nopisland/Sumositoire/Sumositoire_projet_etudiant/Sumositoire/jalon1/Planning_SUMOSITOIRE_B1a_eq2.pdf

# PLANNING DE DEVELOPPEMENT DU PROJET (PDP)

# Mise en place du planning de developpement

Action | NOM Prénom | Fonction | Date | Signature
Document complété par | MAFILAZA Donnie BOISSONNEAU Jimmy | Techniciens | 29/09/15
Planning validée par | BOISSONNEAU Jimmy | Chef de projet | 29/09/15

# IUT de Bordeaux

Département GEII | 1 / 2

# Etape du projet :

# Référence : RBS_PDP Révision : 1.0 – 01/09/2015

## PLANNING DE DEVELOPPEMENT DU PROJET (PDP)

TEMPS (en séance)

| | | | | S1 | | S2 | | | S3 | | S4 | | | S5 | | S6 | | | S7 | | S8 | | | S9 | | S10 | | | S11 | | S12 | | | S13 | | S14 | | | S15 | | S16 | | | S17 | | S18 | | | S19 | | S20 | | | S21
TACHE | TEMPS (en h) | EQUIPIERS | DUREE | 1 | 2 | 3 | 4 | 5 | 6 | 7 | 8 | 9 | 10 | 11 | 12 | 13 | 14 | 15 | 16 | 17 | 18 | 19 | 20 | 21 | 22 | 23 | 24 | 25 | 26 | 27 | 28 | 29 | 30 | 31 | 32 | 33 | 34 | 35 | 36 | 37 | 38 | 39 | 40 | 41 | 42 | 43 | 44 | 45 | 46 | 47 | 48 | 49 | 50 | 51 | 52 | COMMENTAIRES
1 | REVUE DE LANCEMENT DE DEVELOPPEMENT | Présentation du projet
2 | FORMATION PROCESSUS | Présentation du processus de développement
3 | CAHIER DES CHARGES | Prise de connaissance des exigences
4 | PLANNING | Prise de connaissance du planning prévisionnel du projet
5 | RESSOURCES HUMAINES | Constitution des groupes et des binômes 12, 34, 56 et 78
6 | COUT | Prise de connaissance du coût prévisionnel du projet
7 | ARCHITECTURE MECANIQUE | Analyse de la conformité des solutions techniques disponibles par rapport aux exigences
8 | ARCHITECTURE ELECTRONIQUE | Association exigences et blocs architecturaux du projet
9 | ARCHITECTURE ELECTRONIQUE EXEMPLE | Analyse de l'exemple fourni
10 | ARCHITECTURE ELECTRONIQUE ACQUISITION | Recherche solutions techniques en réponse aux exigences (avec analyse des composants d'acquisitions disponibles)
11 | ARCHITECTURE ELECTRONIQUE TRAITEMENT | Recherche solutions techniques en réponse aux exigences (avec des fonctionnalités du composant de traitement disponible)
12 | ARCHITECTURE ELECTRONIQUE ACTION | Recherche solutions techniques en réponse aux exigences (avec analyse du composant d'action disponible (caractéristiques mécanique, tension, courant + protocole de commande))
13 | ARCHITECTURE ELECTRONIQUE ENERGIE | Analyse de la conformité des solutions techniques disponibles par rapport aux exigences
14 | ARCHITECTURE INFORMATIQUE | Association exigences et blocs architecturaux du projet
15 | ARCHITECTURE INFORMATIQUE EXEMPLE | Analyse de l'exemple fourni
16 | ARCHITECTURE INFORMATIQUE ACQUISITION | Déclarations des prototypes des fonctions d'acquisition
17 | ARCHITECTURE INFORMATIQUE TRAITEMENT | Déclarations des prototypes des fonctions de traitement
18 | ARCHITECTURE INFORMATIQUE ACTION | Déclarations des prototypes des fonctions d'action
19 | ARCHITECTURE MECANIQUE
20 | ARCHITECTURE ELECTRONIQUE
21 | ARCHITECTURE INFORMATIQUE
22 | REVUE DE CONCEPTION PRELIMINAIRE | Préparation checklist + revue
23 | CONCEPTION ELECTRONIQUE ACQUISITION | Lecture datasheet, calcul, simulation
24 | CONCEPTION ELECTRONIQUE TRAITEMENT | Lecture datasheet
25 | CONCEPTION ELECTRONIQUE ACTION | Lecture datasheet, calcul, simulation
26 | CONCEPTION ELECTRONIQUE ENERGIE | Lecture datasheet, calcul, simulation
27 | CONCEPTION ELECTRONIQUE CIRCUIT IMPRIME | schéma électrique, placement, routage
28 | CONCEPTION INFORMATIQUE ACQUISITION | Définitions et instanciations des prototypes des fonctions d'acquisition
29 | CONCEPTION INFORMATIQUE TRAITEMENT | Définitions et instanciations des fonctions de traitement
30 | CONCEPTION INFORMATIQUE ACTION | Définitions et instanciations des fonctions d'action
31 | CONCEPTION MECANIQUE | Construction de plan mécanique
32 | CONCEPTION ELECTRONIQUE DDC
33 | CONCEPTION INFORMATIQUE DDC
34 | CONCEPTION ELECTRONIQUE DDF | Rédaction du DDF + traçabilité entre paragraphes de fabrication et exigences clients
35 | CONCEPTION MECANIQUE DDF | Rédaction du DDF + traçabilité entre paragraphes de fabrication et exigences clients
36 | REVUE DE CONCEPTION DETAILLEE | Préparation checklist + revue
37 | FABRICATION MECANIQUE | Réalisation de la structure mécanique
38 | FABRICATION ELECTRONIQUE | Réalisation du circuit électronique
39 | REVUE DE FABRICATION | Préparation checklist + revue
40 | TELECHARGEMENT INFORMATIQUE | Téléchargement du programme informatique dans le prototype
41 | DEBOGAGE ELECTRONIQUE | Mise-au-point du circuit électronique
42 | DEBOGAGE INFORMATIQUE | Mise-au-point du programme informatique
43 | ASSEMBLAGE | Mise-au-point mécanique, électronique et informatique après assemblage
44 | DEBOGAGE | Mise-au-point du prototype entièrement assemblé
45 | VERIFICATION MECANIQUE | Essais de vérification sur prototype + rédaction de l'essai dans le DDV
46 | VERIFICATION ACQUISITION | Essais de vérification sur prototype + rédaction de l'essai dans le DDV
47 | VERIFICATION TRAITEMENT | Essais de vérification sur prototype + rédaction de l'essai dans le DDV
48 | VERIFICATION ACTION | Essais de vérification sur prototype + rédaction de l'essai dans le DDV
49 | VERIFICATION ENERGIE | Essais de vérification sur prototype + rédaction de l'essai dans le DDV
50 | VERIFICATION DDV | Finalisation du DDV + traçabilité entre essais et exigences clients
51 | MARGE | Marge dans le planning
52 | DEMONSTRATION | Démonstration du bon fonctionnement du prototype développé
53 | REVUE DE FIN DE DEVELOPPEMENT | Préparation checklist + revue

GLOSSAIRE

Equipier1 | Equipier4 | Equipier7 | BOISSONNneau | MARANDEL
| | | BOUYER | SENEL
Equipier2 | Equipier5 | | LIZOT
| | | MAFILAZA
Equipier3 | Equipier6 | Equipiers1&2&3&4&5&6&7
1&3 | 4&6 | 2&5 | 1&5

Rédaction du chapitre « Conception Préliminaire » du DDC Rédaction du chapitre « Conception Préliminaire » du DDC Rédaction du chapitre « Conception Préliminaire » du DDC

Rédaction du chapitre « Conception détaillée » du DDC+ traçabilité entre paragraphes de conception et exigences clients Rédaction du chapitre « Conception détaillée » du DDC + traçabilité entre paragraphes de conception et exigences clients

Equipier 1 : | Equipier 5 :
Equipier 2 : | Equipier 6 :
Equipier 3 : | Equipier 7 :
Equipier 4 :
