nopisland/Sumositoire/Sumositoire_reborn/MECA/.m3d BambuLab P1S/batch complet.3mf

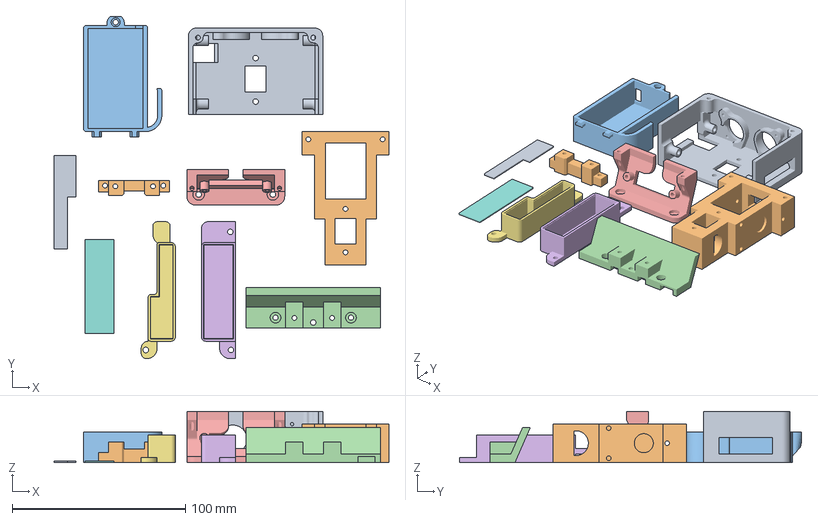
[picture p20: CAD file, 2026-01-16]
Sumositoire_reborn/MECA/.m3d BambuLab P1S/batch complet.3mf
193.2 x 197.4 x 29.5 mm
support ultrasons v55.stl
base v5.stl
batch_one_sumo - Part 1 v7.stl
parebot v6.stl
support sharp arrière v18.stl
ajout de poid en dessous droite v13.stl
ajout de poid en dessous Gauche v20.stl
couvverture poids droite v2.stl
couverture poids gauche v4.stl
capteur_arriere_dessous v4.stl
