nopisland/Sumositoire/Sumositoire_reborn/MECA/Fichier STL/ajout de poid en dessous droite v13.stl

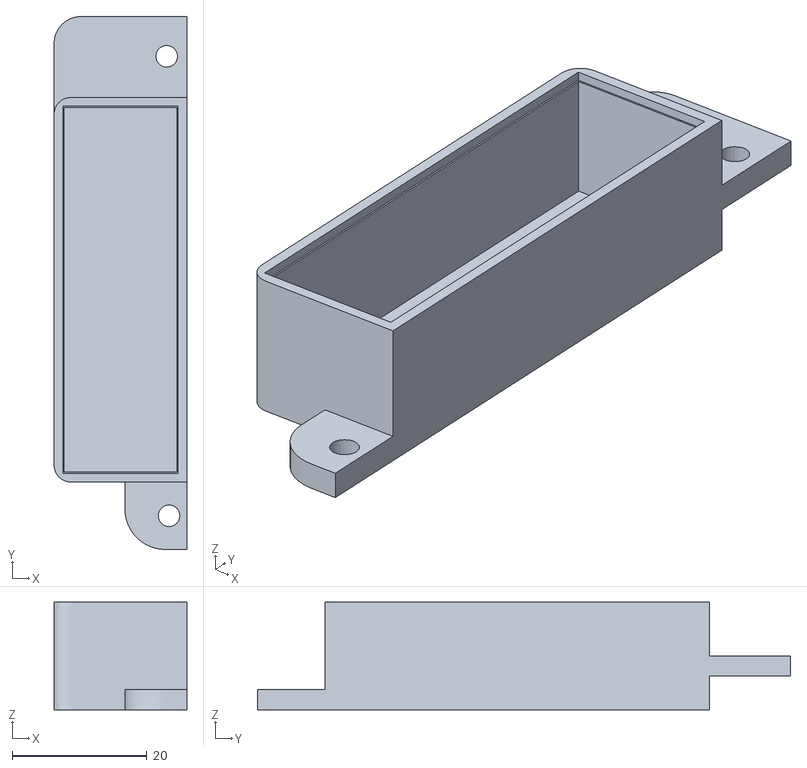
[picture p21: CAD file, 2026-01-16]
Sumositoire_reborn/MECA/Fichier STL/ajout de poid en dessous droite v13.stl
19.7 x 79.0 x 16.0
