nopisland/Sumositoire/Sumositoire_reborn/MECA/Modéle 3d Capteur et carte/cny_arriere.stl

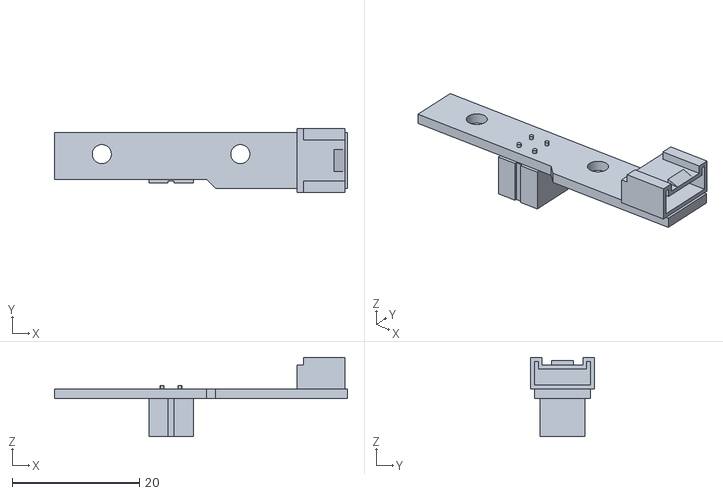
[picture p22: CAD file, 2026-01-16]
Sumositoire_reborn/MECA/Modéle 3d Capteur et carte/cny_arriere.stl
46.0 x 10.0 x 12.4
