nopisland/Sumositoire/Sumositoire_reborn/MECA/Fichier STL/support poids roues v15.stl

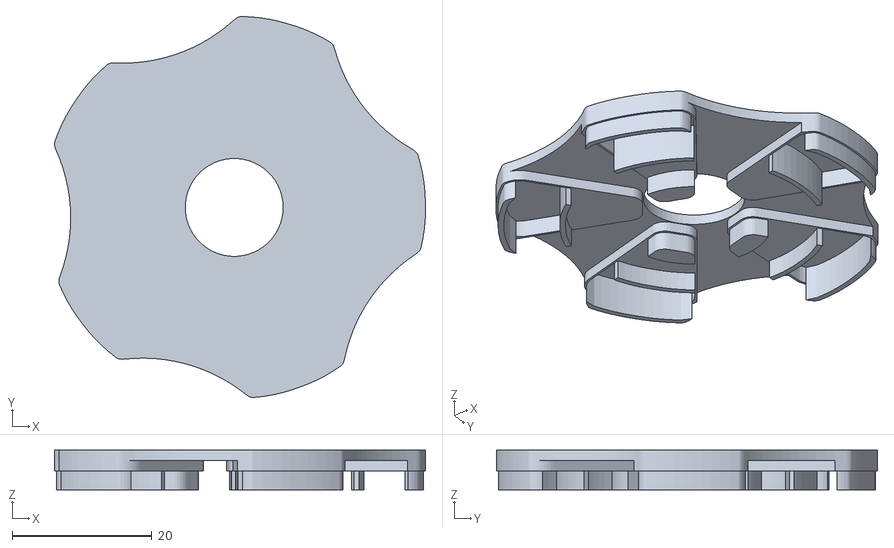
[picture p23: CAD file, 2026-01-16]
Sumositoire_reborn/MECA/Fichier STL/support poids roues v15.stl
53.1 x 54.5 x 5.70
