nopisland/Sumositoire/Sumositoire_reborn/MECA/Modéle 3d Capteur et carte/sharp.stl

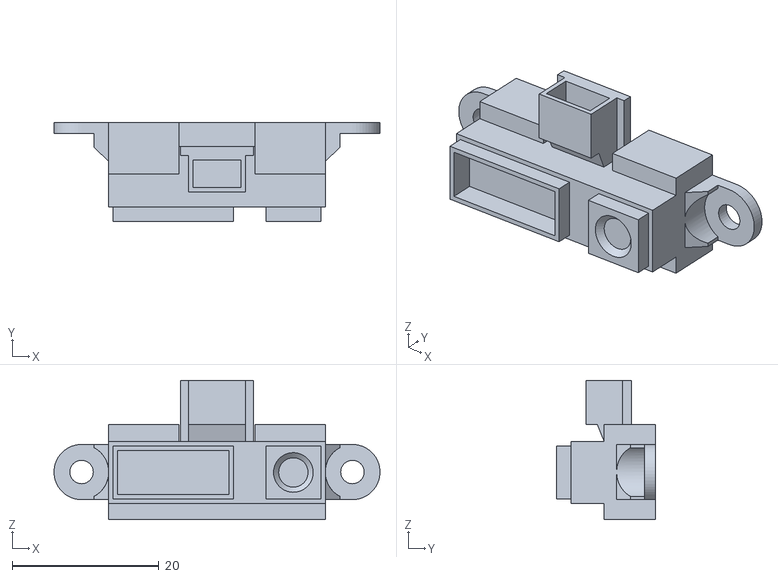
[picture p24: CAD file, 2026-01-16]
Sumositoire_reborn/MECA/Modéle 3d Capteur et carte/sharp.stl
44.4 x 13.5 x 19.0
