nopisland/Sumositoire/Sumositoire_reborn/MECA/Fichier STL/batch_one_sumo - Part 1 v7.stl

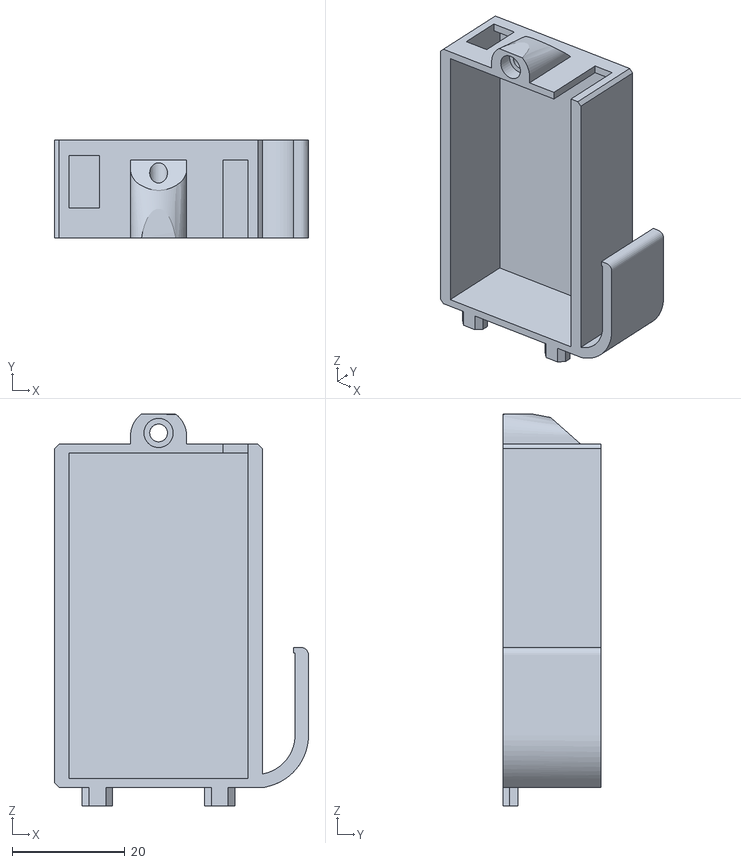
[picture p25: CAD file, 2026-01-16]
Sumositoire_reborn/MECA/Fichier STL/batch_one_sumo - Part 1 v7.stl
45.1 x 17.5 x 69.7
