nopisland/Sumositoire/Sumositoire_reborn/MECA/Modéle 3d Capteur et carte/roue.stl

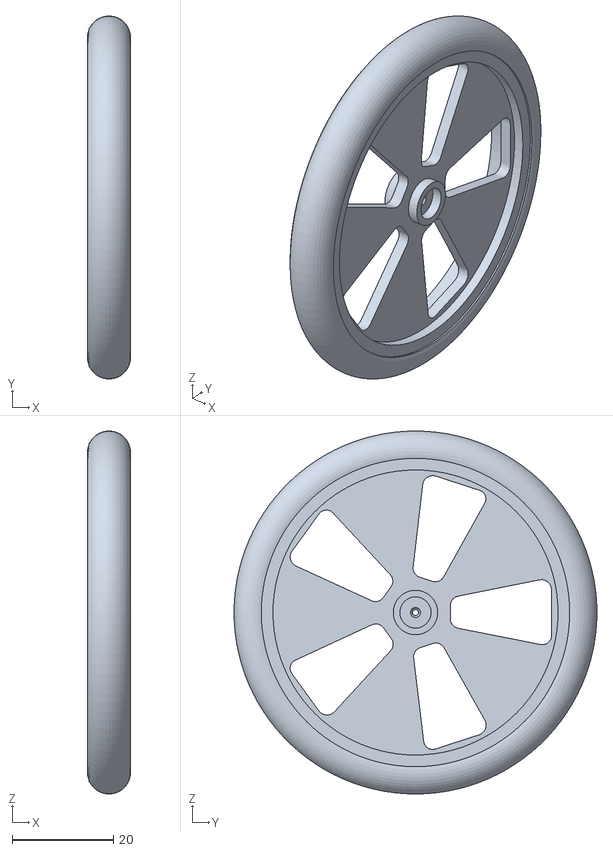
[picture p26: CAD file, 2026-01-16]
Sumositoire_reborn/MECA/Modéle 3d Capteur et carte/roue.stl
8.53 x 71.8 x 71.8
