nopisland/Sumositoire/Sumositoire_reborn/MECA/Fichier STL/base v5.stl

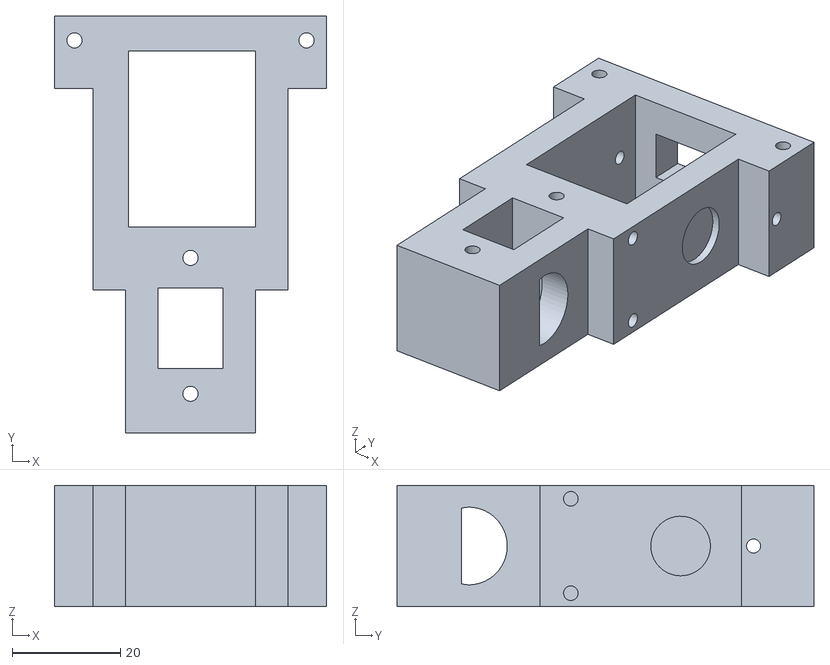
[picture p27: CAD file, 2026-01-16]
Sumositoire_reborn/MECA/Fichier STL/base v5.stl
50.2 x 76.9 x 22.3
