nopisland/Sumositoire/Sumositoire_reborn/MECA/Modéle 3d Capteur et carte/ultrason.stl

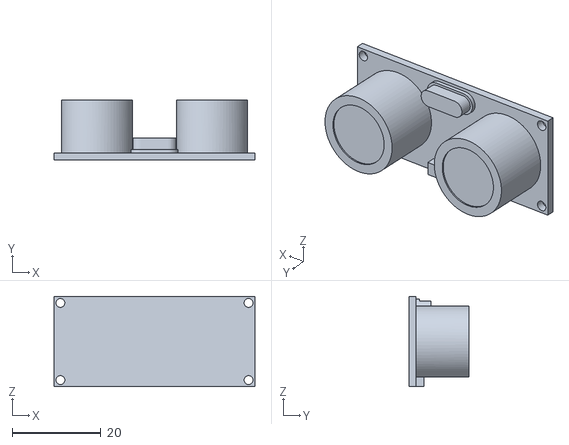
[picture p28: CAD file, 2026-01-16]
Sumositoire_reborn/MECA/Modéle 3d Capteur et carte/ultrason.stl
45.4 x 13.6 x 20.4
