nopisland/Sumositoire/Sumositoire_reborn/MECA/Fichier STL/capteur_arriere_dessous v4.stl

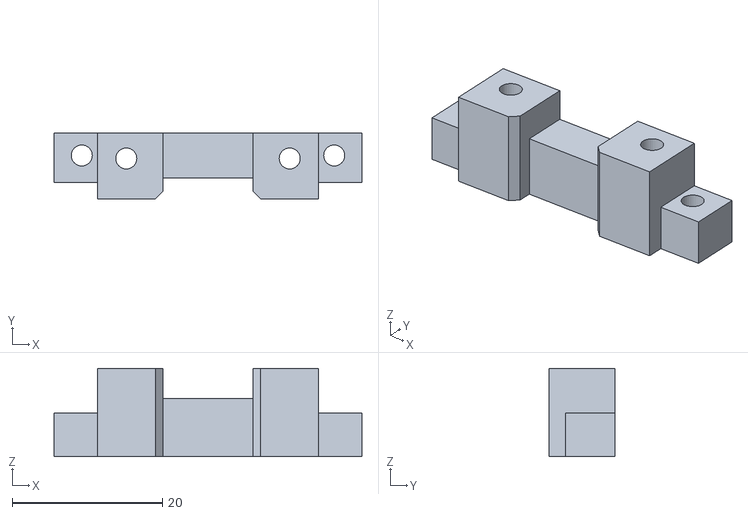
[picture p29: CAD file, 2026-01-16]
Sumositoire_reborn/MECA/Fichier STL/capteur_arriere_dessous v4.stl
41.0 x 8.80 x 11.7
