nopisland/Sumositoire/Sumositoire_reborn/MECA/Modéle 3d Capteur et carte/cny_avant.stl

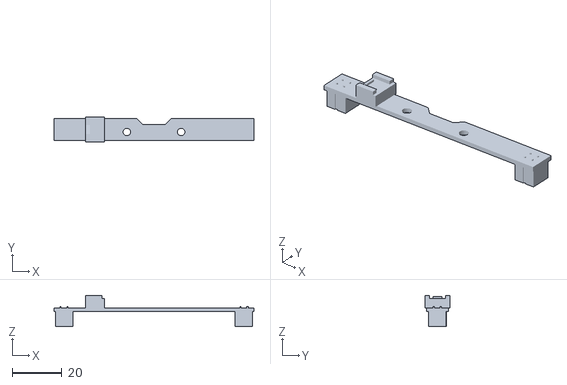
[picture p30: CAD file, 2026-01-16]
Sumositoire_reborn/MECA/Modéle 3d Capteur et carte/cny_avant.stl
80.0 x 10.0 x 12.4
