nopisland/Sumositoire/Sumositoire_reborn/MECA/Fichier STL/couvverture poids droite v2.stl

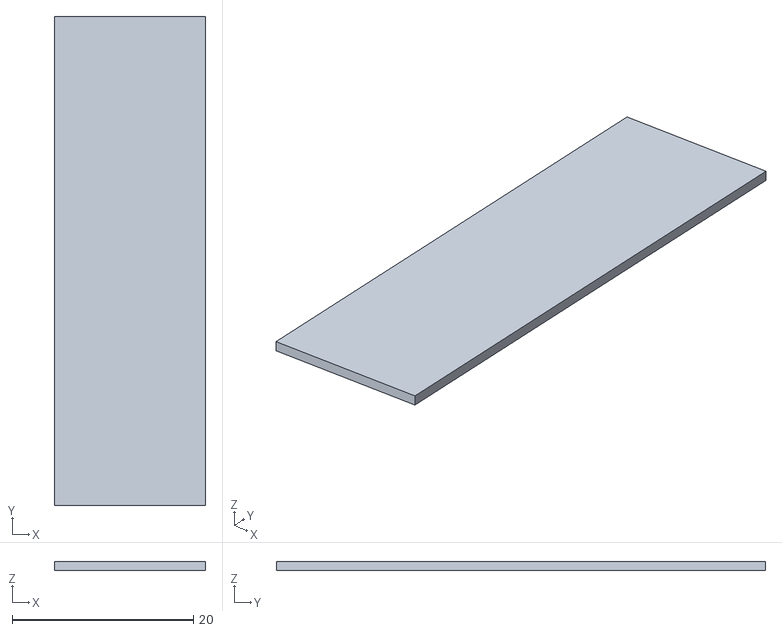
[picture p31: CAD file, 2026-01-16]
Sumositoire_reborn/MECA/Fichier STL/couvverture poids droite v2.stl
16.7 x 54.0 x 1.00
