nopisland/Sumositoire/Sumositoire_reborn/MECA/Modéle 3d Capteur et carte/moteur.stl

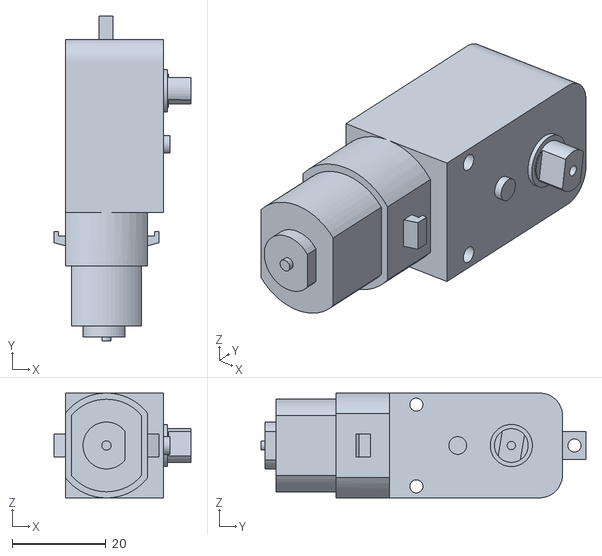
[picture p32: CAD file, 2026-01-16]
Sumositoire_reborn/MECA/Modéle 3d Capteur et carte/moteur.stl
29.2 x 69.3 x 22.3
