nopisland/Sumositoire/Sumositoire_reborn/MECA/Fichier STL/support ultrasons v55.stl

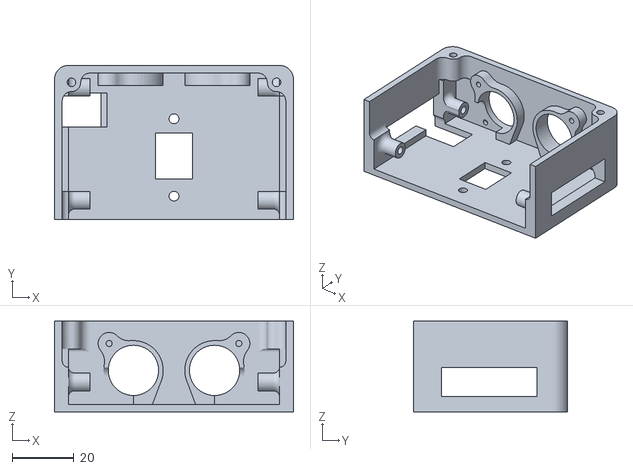
[picture p33: CAD file, 2026-01-16]
Sumositoire_reborn/MECA/Fichier STL/support ultrasons v55.stl
77.5 x 50.0 x 29.5
