nopisland/Sumositoire/Sumositoire_reborn/MECA/Fichier STL/ajout de poid en dessous Gauche v20.stl

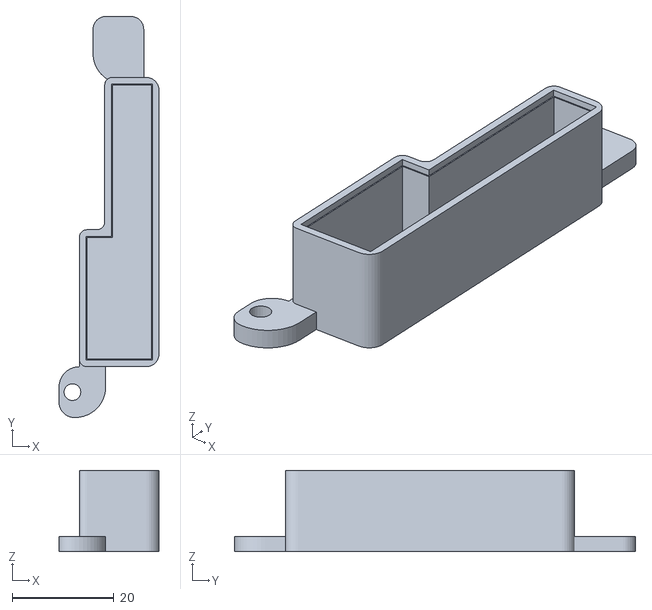
[picture p34: CAD file, 2026-01-16]
Sumositoire_reborn/MECA/Fichier STL/ajout de poid en dessous Gauche v20.stl
19.7 x 79.0 x 16.0
