nopisland/Sumositoire/Sumositoire_reborn/MECA/Fichier STL/support sharp arrière v18.stl

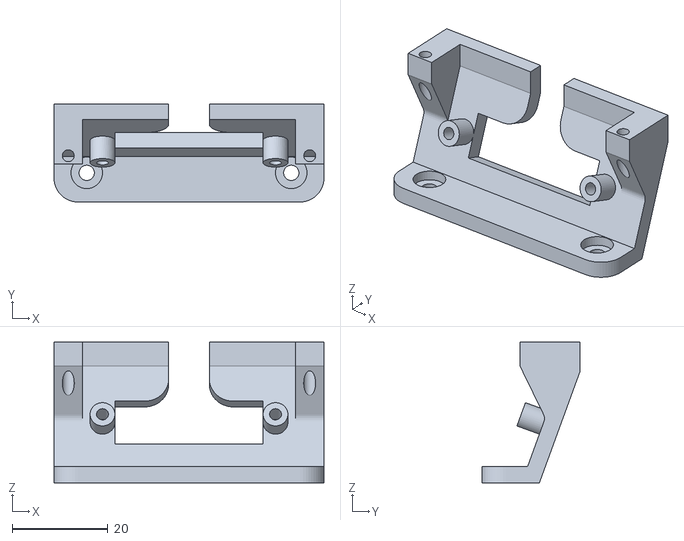
[picture p35: CAD file, 2026-01-16]
Sumositoire_reborn/MECA/Fichier STL/support sharp arrière v18.stl
56.5 x 20.5 x 29.5
