nopisland/Sumositoire/Sumositoire_reborn/MECA/Fichier STL/couverture poids gauche v4.stl

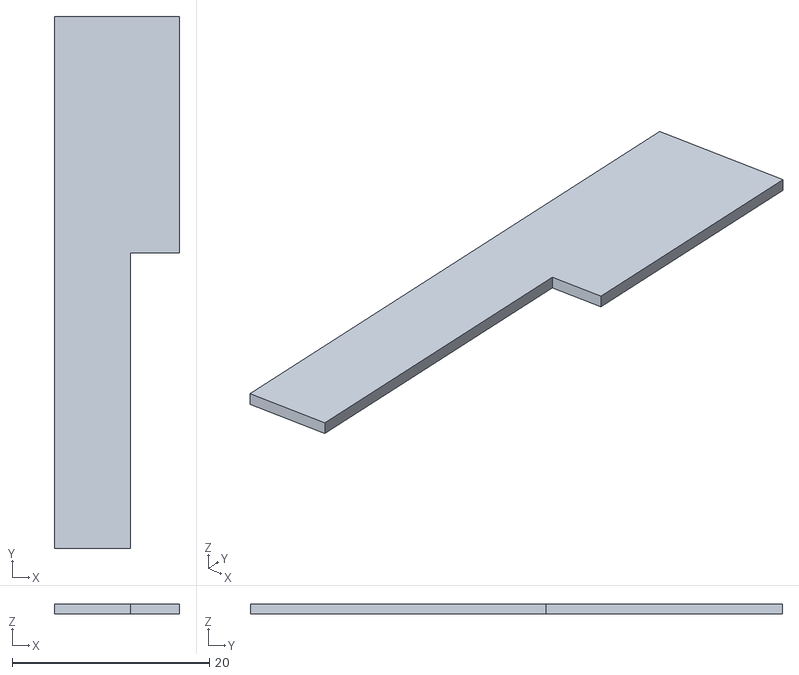
[picture p36: CAD file, 2026-01-16]
Sumositoire_reborn/MECA/Fichier STL/couverture poids gauche v4.stl
12.7 x 54.0 x 1.00
