nopisland/Sumositoire/Sumositoire_reborn/MECA/Fichier STL/parebot v6.stl

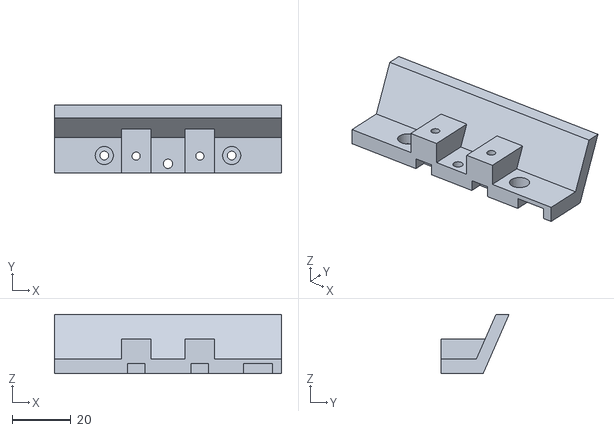
[picture p37: CAD file, 2026-01-16]
Sumositoire_reborn/MECA/Fichier STL/parebot v6.stl
77.5 x 23.3 x 20.2
