nopisland/Sumositoire/indicateur_batterie_v1/indicateur_batterie_v1-F_Cu.pdf

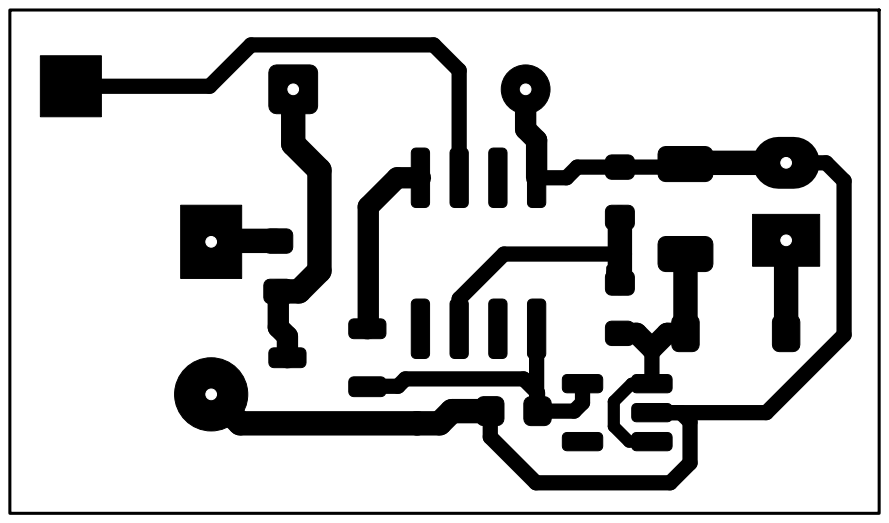
[picture p38: page 1]
