nopisland/Sumositoire/indicateur_batterie_v1/indicateur_batterie_v1.kicad_pcb

## KiCad design indicateur_batterie_v1/indicateur_batterie_v1.kicad_pcb (2026-03-27)

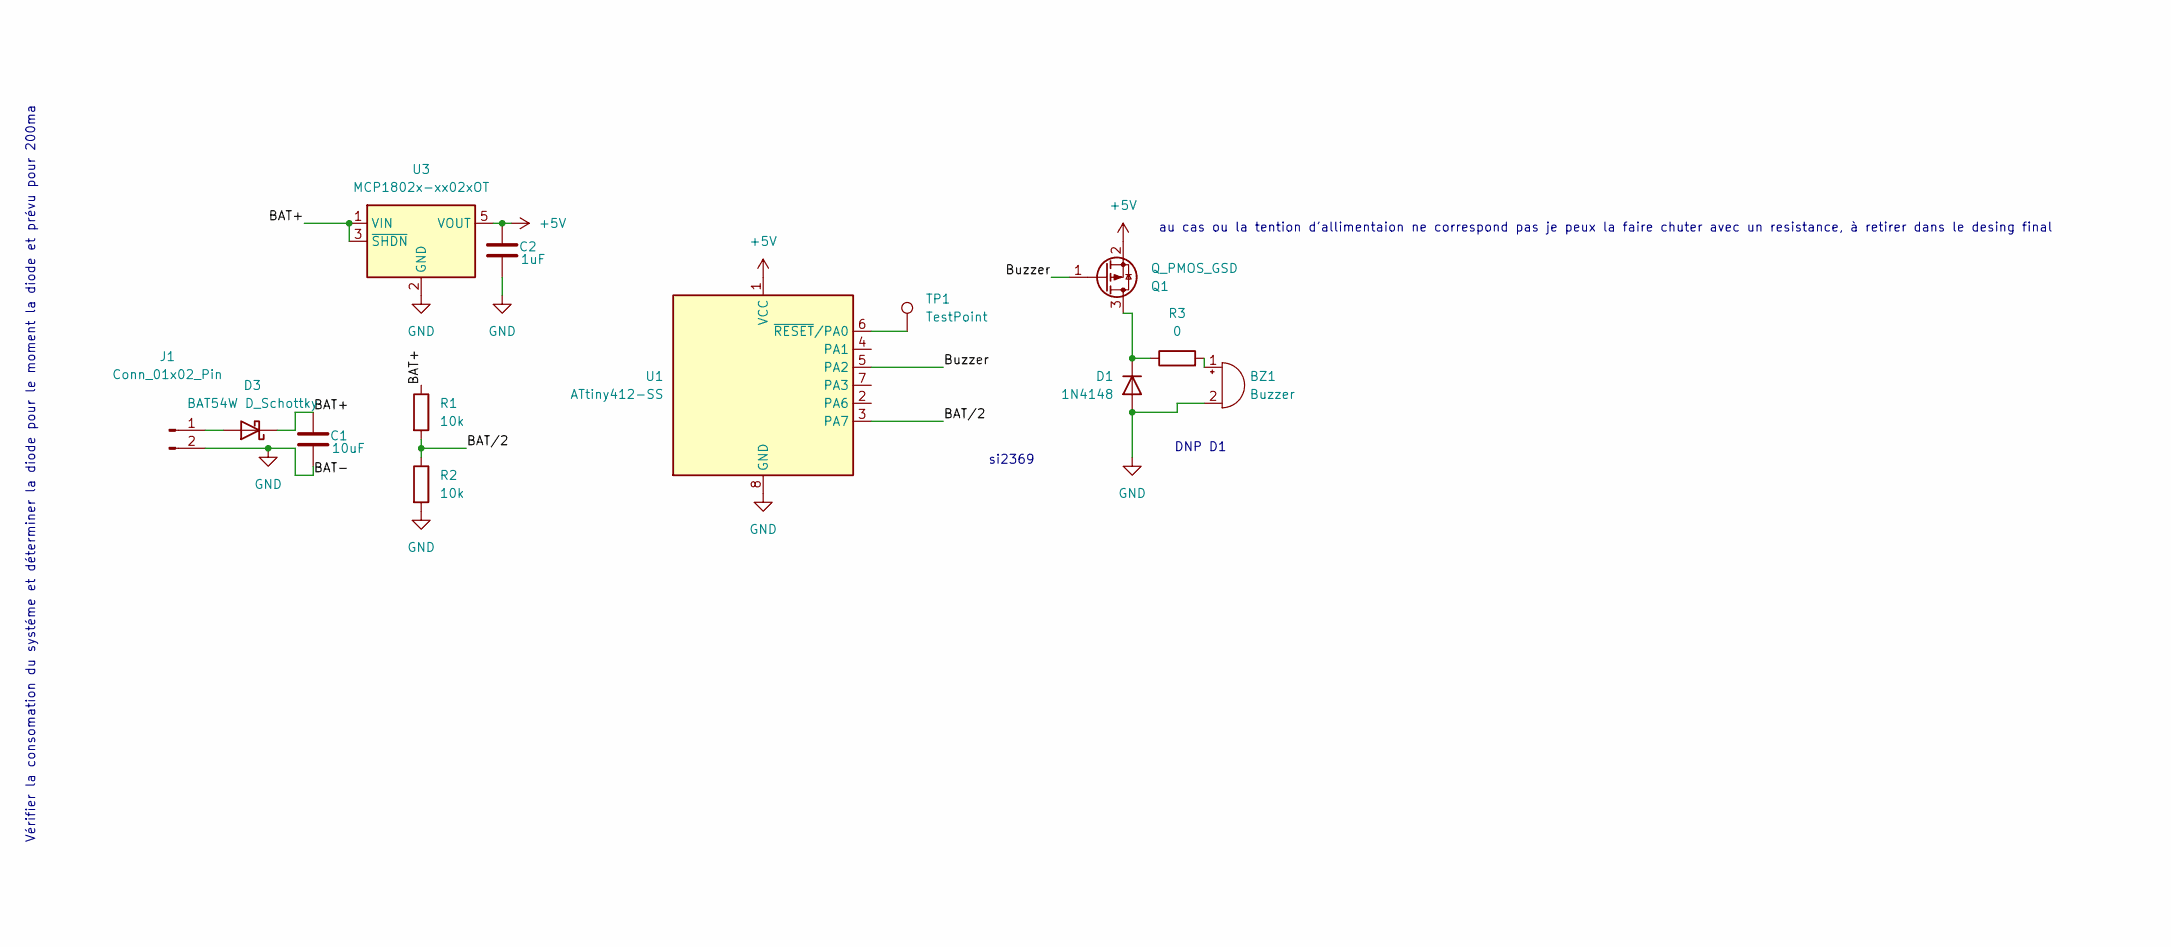
[picture p39: schematic indicateur_batterie_v1.kicad_sch]

Parts:
BZ1: Buzzer; Buzzer_TDK_PS1240P02BT_D12.2mm_H6.5mm
C1: 10uF; C_1206_3216Metric
C2: 1uF; C_0603_1608Metric
D1: 1N4148; D_DO-35_SOD27_P7.62mm_Horizontal
D3: BAT54W D_Schottky; D_SOD-123
J1: Conn_01x02_Pin; PinSocket_1x02_P2.54mm_Vertical
Q1: Q_PMOS_GSD; TSOT-23
R1, R2: 10k; R_0603_1608Metric
R3: 0; R_0603_1608Metric
TP1: TestPoint; TestPoint_Pad_2.0x2.0mm
U1: ATtiny412-SS; SOIC-8_3.9x4.9mm_P1.27mm
U3: MCP1802x-xx02xOT; SOT-23-5

Connections:
+5V: C2.1, Q1.2 (S), U1.1 (VCC), U3.5 (VOUT)
/BAT+: C1.1, D3.1 (K), R1.1, U3.1 (VIN), U3.3 (~SHDN)
/BAT/2: R1.2, R2.1, U1.3 (PA7)
/Buzzer: Q1.1 (G), U1.5 (PA2)
GND: BZ1.2 (-), C1.2, C2.2, D1.2 (A), J1.2, R2.2, U1.8 (GND), U3.2 (GND)
unnamed: BZ1.1 (+), R3.2
unnamed: D1.1 (K), Q1.3 (D), R3.1
unnamed: D3.2 (A), J1.1
unnamed: TP1.1, U1.6 (~RESET/PA0)

Notes on the sheet:
au cas ou la tention d'allimentaion ne correspond pas je peux la faire chuter avec un resistance, à retirer dans le desing final
si2369
Vérifier la consomation du systéme et déterminer la diode pour le moment la diode et prévu pour 200ma
DNP D1

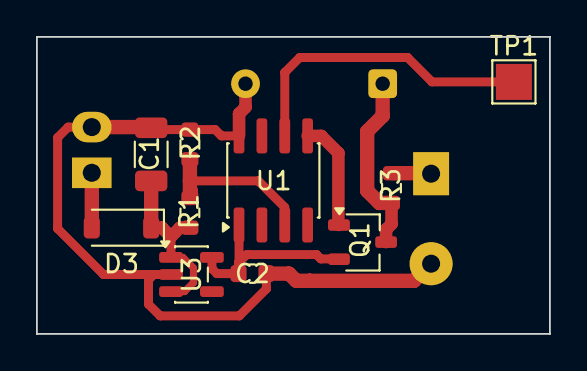
[picture p40: board indicateur_batterie_v1.kicad_pcb from above]

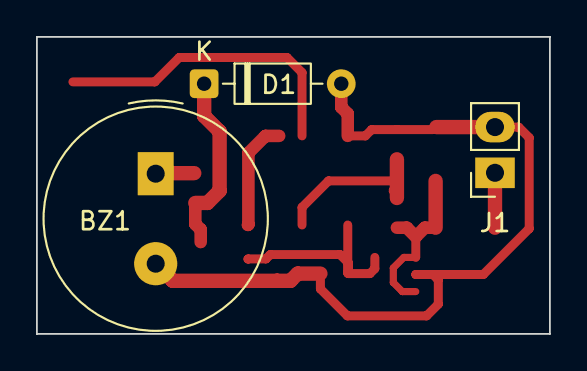
[picture p41: board indicateur_batterie_v1.kicad_pcb from below]

Board: 2 copper layers, 28.5 x 16.5 mm, 13 parts (3 on the bottom side), 9 nets.
