nopisland/Sumositoire/Sumositoire_reborn/KICAD/Sumositoire_reborn.kicad_pcb

## KiCad design Sumositoire_reborn/KICAD/Sumositoire_reborn.kicad_pcb (2026-01-16)

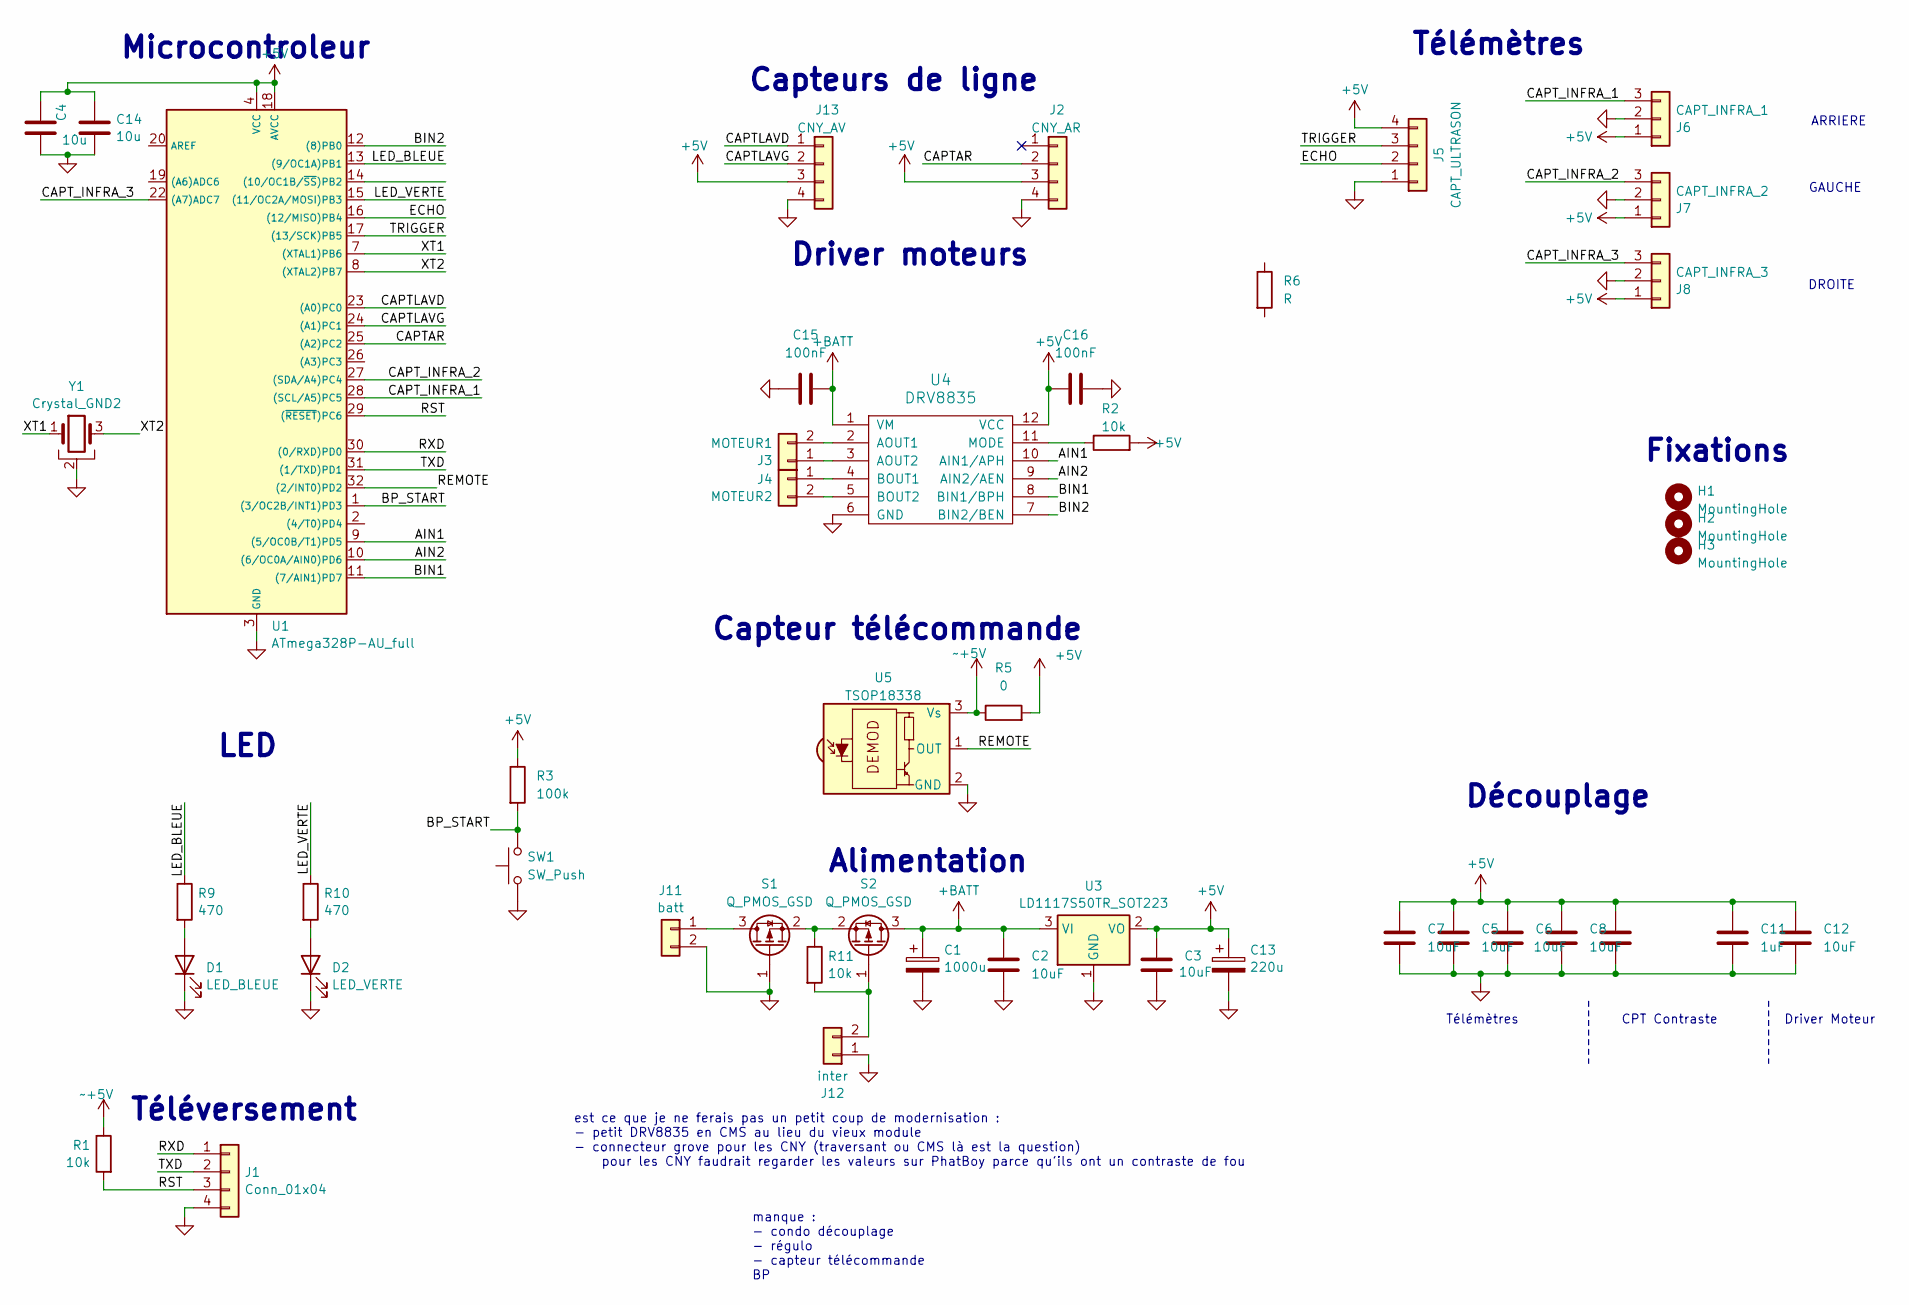
[picture p42: schematic Sumositoire_reborn.kicad_sch]

Parts:
C1: 1000u; CP_Elec_10x10
C2: 10uF; C_0603_1608Metric
C3, C5, C6, C7, C8, C12: 10uF; C_1206_3216Metric
C4, C14: 10u; C_1206_3216Metric
C9, C11: 1uF; C_1206_3216Metric
C13: 220u; C_1206_3216Metric
C15, C16: 100nF; C_0603_1608Metric
D1: LED_BLEUE; LED_1206_3216Metric
D2: LED_VERTE; LED_1206_3216Metric
H1, H2, H3: MountingHole; MountingHole_3.2mm_M3_DIN965_Pad
J1: Conn_01x04; PinSocket_1x04_P2.54mm_Vertical
J2: CNY_AR; GROVE_HY2.0_VERTICAL_SMD
J3: MOTEUR1; PinHeader_1x02_P2.54mm_Horizontal
J4: MOTEUR2; PinHeader_1x02_P2.54mm_Horizontal
J5: CAPT_ULTRASON; PinHeader_1x04_P2.54mm_Horizontal
J6: CAPT_INFRA_1; PinHeader_1x03_P2.54mm_Horizontal
J7: CAPT_INFRA_2; PinHeader_1x03_P2.54mm_Horizontal
J8: CAPT_INFRA_3; PinHeader_1x03_P2.54mm_Horizontal
J11: batt; PinHeader_1x02_P2.54mm_Horizontal
J12: inter; PinHeader_1x02_P2.54mm_Horizontal
J13: CNY_AV; GROVE_HY2.0_VERTICAL_SMD
R1, R2, R11: 10k; R_0603_1608Metric
R3: 100k; R_0603_1608Metric
R5: 0; R_0603_1608Metric
R6: R; D_1206_3216Metric
R9, R10: 470; R_0603_1608Metric
S1, S2: Q_PMOS_GSD; TSOT-23
SW1: SW_Push; BP_Schruter_LSH
U1: ATmega328P-AU_full; TQFP32m
U3: LD1117S50TR_SOT223; SOT-223-3_TabPin2
U4: DRV8835; WSON-12
U5: TSOP18338; Vishay_MOLD-3Pin
Y1: Crystal_GND2; osc_CSTNE

Connections:
+5V: C3.1, C4.1, C5.1, C6.1, C7.1, C8.1, C9.1, C11.1, C12.1, C13.1, C14.1, C16.1, J2.3, J5.4, J6.1, J7.1, J8.1, J13.3, R2.2, R3.1, R5.2, U1.4 (VCC), U1.6 (VCC), U1.18 (AVCC), U3.2 (VO), U4.12 (VCC)
+BATT: C1.1, C2.1, C15.2, S2.3 (D), U3.3 (VI), U4.1 (VM)
/AIN1: U1.9 ((5/OC0B/T1)PD5), U4.10 (AIN1/APH)
/AIN2: U1.10 ((6/OC0A/AIN0)PD6), U4.9 (AIN2/AEN)
/BIN1: U1.11 ((7/AIN1)PD7), U4.8 (BIN1/BPH)
/BIN2: U1.12 ((8)PB0), U4.7 (BIN2/BEN)
/BP_START: R3.2, SW1.2, U1.1 ((3/OC2B/INT1)PD3)
/CAPTAR: J2.2, U1.25 ((A2)PC2)
/CAPTLAVD: J13.1, U1.23 ((A0)PC0)
/CAPTLAVG: J13.2, U1.24 ((A1)PC1)
/CAPT_INFRA_1: J6.3, U1.28 ((SCL/A5)PC5)
/CAPT_INFRA_2: J7.3, U1.27 ((SDA/A4)PC4)
/CAPT_INFRA_3: J8.3, U1.22 ((A7)ADC7)
/ECHO: J5.2, U1.16 ((12/MISO)PB4)
/LED_BLEUE: R9.1, U1.13 ((9/OC1A)PB1)
/LED_VERTE: R10.1, U1.15 ((11/OC2A/MOSI)PB3)
/REMOTE: U1.32 ((2/INT0)PD2), U5.1 (OUT)
/RST: J1.3, R1.2, U1.29 ((~RESET)PC6)
/RXD: J1.1, U1.30 ((0/RXD)PD0)
/TRIGGER: J5.3, U1.17 ((13/SCK)PB5)
/TXD: J1.2, U1.31 ((1/TXD)PD1)
/XT1: U1.7 ((XTAL1)PB6), Y1.1
/XT2: U1.8 ((XTAL2)PB7), Y1.3
GND: C1.2, C2.2, C3.2, C4.2, C5.2, C6.2, C7.2, C8.2, C9.2, C11.2, C12.2, C13.2, C14.2, C15.1, C16.2, D1.1 (K), D2.1 (K), J1.4, J2.4, J5.1, J6.2, J7.2, J8.2, J11.2, J12.1, J13.4, S1.1 (G), SW1.1, U1.3 (GND), U1.5 (GND), U1.21 (GND), U3.1 (GND), U4.6 (GND), U5.2 (GND), Y1.2
unnamed: D1.2 (A), R9.2
unnamed: D2.2 (A), R10.2
unnamed: J3.1, U4.3 (AOUT2)
unnamed: J3.2, U4.2 (AOUT1)
unnamed: J4.1, U4.4 (BOUT1)
unnamed: J4.2, U4.5 (BOUT2)
unnamed: J11.1, S1.3 (D)
unnamed: J12.2, R11.2, S2.1 (G)
unnamed: R11.1, S1.2 (S), S2.2 (S)
unnamed: R2.1, U4.11 (MODE)
~+5V: R1.1, R5.1, U5.3 (Vs)

Notes on the sheet:
Microcontroleur
Driver Moteur
Télémètres
CPT Contraste
GAUCHE
est ce que je ne ferais pas un petit coup de modernisation : - petit DRV8835 en CMS au lieu du vieux module - connecteur grove pour les CNY (traversant ou CMS là est la question) pour les CNY faudrait regarder les valeurs sur PhatBoy parce qu'ils ont un contraste de fou
LED
manque : - condo découplage - régulo - capteur télécommande BP
Téléversement
Fixations
Alimentation
ARRIERE
Capteur télécommande
DROITE
Découplage
Capteurs de ligne
Driver moteurs

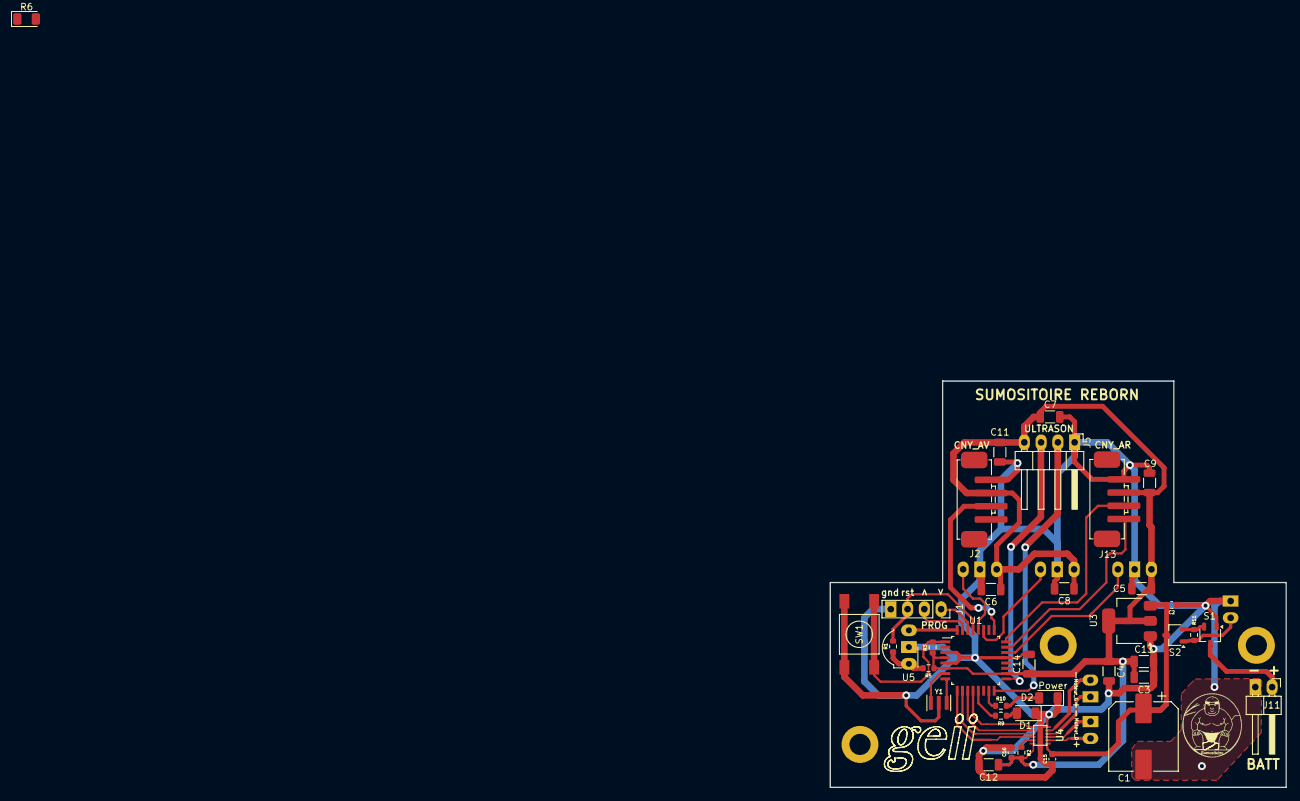
[picture p43: board Sumositoire_reborn.kicad_pcb from above]

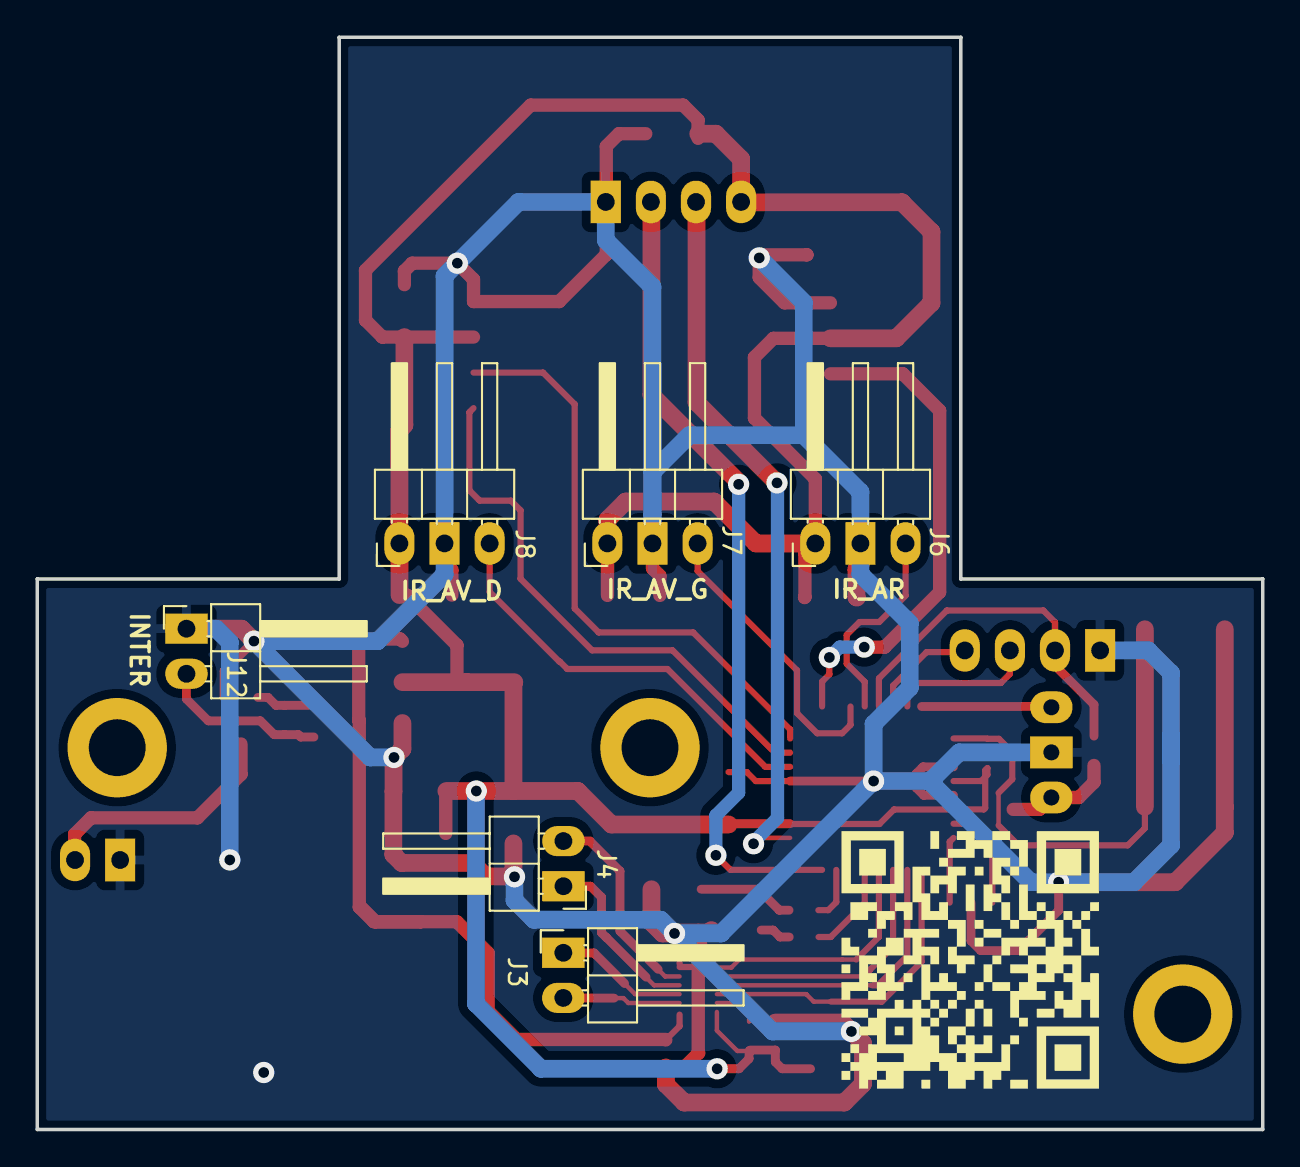
[picture p44: board Sumositoire_reborn.kicad_pcb from below]

Board: 2 copper layers, 69.0 x 61.5 mm, 48 parts (6 on the bottom side), 35 nets.

Other parts of the board:
Ref**: Val**; logo_geii_fsilk
