nopisland/Sumositoire/Sumositoire_reborn/code_sumositoire_reborn/Sumositoire_reborn/Sumositoire_reborn.ino

/* -------------------------------------------------------------
 			Auteur : Val
 			DUT : GEII.
 			Date : 14/10/2015 / 23h09.
  --------------------------------------------------------------*/

#define remote 2


//sharpe
#define pin1 A5  //sharp arrier
#define pin2 A4 //sharp gauche
#define pin3 A7 //sharp droite
int sueil_infra_arierre = 5;
int sueil_infra_droite = 5;
int sueil_infra_gauche = 5;
#define SHAR 16
#define SHG 32
#define SHD 64

//Ligne var
int input_ligne_ar = A2;
#define AR 1

int input_ligne_ar_G = A1;
#define AVG 2

int input_ligne_ar_D = A0;
#define AVD 4

double value1, distance1, value2, distance2, value3, distance3;
int valeur_arl, valeur_avg, valeur_avd;

//US var
int trig = 13;
int echo = 12;
long lecture_echo;
long cm;
int sueil_ultrason = 40;
#define US 8


// Motors
const byte moteur_gauche[] = {8, 7}; //Bin2_-_Bin1
const byte moteur_droite[] = {6, 5}; //Ain2_-_Ain1
enum { TOUT_DROIT = 1, MARCHE_ARRIERE, GAUCHE, DROITE, STOP};

//led
const byte led_g = 11, led_b = 9;
//button
const byte button = 3;

byte arret = 0;


void setup() {
  Serial.begin(115200);
  //LED Setup
  pinMode(led_b, OUTPUT);
  pinMode(led_g, OUTPUT);
  pinMode(button, INPUT_PULLUP);

  //Ligne Setup
  pinMode(input_ligne_ar, INPUT);
  pinMode(input_ligne_ar_G, INPUT);
  pinMode(input_ligne_ar_D, INPUT);

  //US Setup
  pinMode(trig, OUTPUT);
  digitalWrite(trig, LOW);
  pinMode(echo, INPUT);

  //sharp
  pinMode(pin1, INPUT);
  pinMode(pin2, INPUT);
  pinMode(pin3, INPUT);

  //Motor Setup
  int i;
  for (i = 0; i < 2; i++) {
    pinMode(moteur_gauche[i], OUTPUT);           // moteur gauche.
    pinMode(moteur_droite[i], OUTPUT);           // moteur droit.

  }
  digitalWrite(led_g,HIGH);
}

byte Checkcapte()
{
  byte var = 0;
  byte sharpEtat = sharp();
  if (analogRead(input_ligne_ar) < 250)
  {
    var |= AR;
  }
  if (analogRead(input_ligne_ar_G) < 250)
  {
    var |= AVG;
  }
  if (analogRead(input_ligne_ar_D) < 250)
  {
    var |= AVD;
  }
  if (ultrason() == 1)
  {
    var |= US;
  }
  if (sharpEtat == 1)
  {
    var |= SHAR;
  }
  if (sharpEtat == 2)
  {
    var |= SHG;
  }
  if (sharpEtat == 4)
  {
    var |= SHD;
  }
  return (var);
}

byte Priocapte(byte var)
{
  if (var & AVG && var & AVD)
    return (AVG | AVD);

  if (var & AVG)
  {
    return (AVG);
  }
  if (var & AVD)
  {
    return (AVD);
  }
  if (var & AR)
  {
    return (AR);
  }
  if (var &  US && var & SHG)
  {
    return (SHG);
  }
  if (var &  US && var & SHD)
  {
    return (SHD);
  }
  if (var &  US && var & SHAR)
  {
    return (SHAR);
  }
  if (var & SHG)
  {
    return (SHG);
  }
  if (var & SHD)
  {
    return (SHD);
  }
  if (var & SHAR)
  {
    return (SHAR);
  }
  if (var & US)
  {
    return (US);
  }
  return (var);
}

byte mouvement(int direction, byte ancienetat = 0, int temps = 0)
{
  Serial.print("mouvement(");
  Serial.print(direction);
  switch (direction)
  {
    case MARCHE_ARRIERE: // Marche-arrière.
      //Avant();
      analogWrite(moteur_gauche[0], 255);
      digitalWrite(moteur_gauche[1], HIGH);

      analogWrite(moteur_droite[0], 255);
      digitalWrite(moteur_droite[1], HIGH);
      break;

    case TOUT_DROIT:  // Tout droit.
      analogWrite(moteur_gauche[0], 255);
      digitalWrite(moteur_gauche[1], LOW);

      analogWrite(moteur_droite[0], 255);
      digitalWrite(moteur_droite[1], LOW);
      break;

    case  DROITE: // Droite.
      analogWrite(moteur_gauche[0], 255);
      digitalWrite(moteur_gauche[1], LOW);

      analogWrite(moteur_droite[0], 255);
      digitalWrite(moteur_droite[1], HIGH);
      break;

    case GAUCHE: // Gauche.
      analogWrite(moteur_gauche[0], 255);
      digitalWrite(moteur_gauche[1], HIGH);

      analogWrite(moteur_droite[0], 255);
      digitalWrite(moteur_droite[1], LOW);
      break;

    case STOP: // Stop
      analogWrite(moteur_gauche[0], 0);
      digitalWrite(moteur_gauche[1], LOW);

      analogWrite(moteur_droite[0], 0);
      digitalWrite(moteur_droite[1], LOW);
      break;
  }
  if (temps != 0)
  {
    temps /= 10;
    int compteur = 0;
    byte nouveletat = ancienetat;
    while (nouveletat == ancienetat && compteur < temps)
    {
      delay(10);
      compteur++;
      nouveletat = Priocapte(Priocapte(Checkcapte()) | ancienetat); // SOME AWESOME MAGIC
    }
    if (compteur != temps)
      return (1);
  }
  return (0);
}

byte action ()
{
  byte etat = Priocapte(Checkcapte());

  Serial.print(etat, BIN);
  Serial.print("   ");
  Serial.println(arret);
  switch (etat)
  {
    case 0:
      
     
      return (0);

    case AR: // Capteur Line Arriere Actif
      digitalWrite(led_g, LOW);
      digitalWrite(led_b, HIGH);
      mouvement(TOUT_DROIT);
      break;

    case (AVG|AVD): // Capteur Line Gauche et Droit Actif
      digitalWrite(led_g, HIGH);
      digitalWrite(led_b, HIGH);
      if (mouvement(MARCHE_ARRIERE, etat, 200) == 1)
        return (1);
      if (mouvement(DROITE, etat, 200) == 1)
        return (1);
      mouvement(TOUT_DROIT);
      break;

    case AVG: // Capteur Line Gauche Actif
      digitalWrite(led_g, HIGH);
      digitalWrite(led_b, LOW);
      if (mouvement(MARCHE_ARRIERE, etat, 200) == 1)
        return (1);
      if (mouvement(DROITE, etat, 200) == 1)
        return (1);
      mouvement(TOUT_DROIT);
      break;

    case AVD: // Capteur Line Droit Actif
      digitalWrite(led_g, HIGH);
      digitalWrite(led_b, LOW);
      if (mouvement(MARCHE_ARRIERE, etat, 200) == 1)
        return (1);
      if (mouvement(GAUCHE, etat, 200) == 1)
        return (1);
      mouvement(TOUT_DROIT);
      break;

    case US: // Capteur Ultrason
      mouvement(TOUT_DROIT);
      break;

    case SHG: // Capteur Sharp Gauche Actif
      if (mouvement(GAUCHE, etat, 200) == 1)
        return (1);
      mouvement(TOUT_DROIT);
      break;

    case SHD: // Capteur Sharp Droit Actif
      if (mouvement(DROITE, etat, 200) == 1)
        return (1);
      mouvement(TOUT_DROIT);
      break;

    case SHAR: // Capteur Sharp Arriere Actif
      mouvement(MARCHE_ARRIERE);
      break;

    default:
      break;
  }
  return (0);
}

byte ultrason()
{
  static byte ct = 0;
  static byte ancieneco = 0;
  if (ct == 10)
  {
    ct = 0;
    ancieneco = aquisition();
  }
  ct ++;
  return (ancieneco);
}
byte aquisition()
{
  digitalWrite(trig, HIGH);
  digitalWrite(trig, LOW);
  lecture_echo = pulseIn(echo, HIGH, 10000);
  cm = lecture_echo / 58;
  if (cm < 1)
  {
    cm = 150;
  }
  if (cm <= sueil_ultrason)
  {
    return (1);
  }
  return (0);
}

byte sharp()
{
  //sharp arriere
  distance1 = get_IR1 ();
  if (distance1 <= sueil_infra_arierre)
  {
    return (1);
  }

  //sharpe gauche
  distance2 = get_IR2 ();
  if (distance2 <= sueil_infra_droite)
  {
    return (2);
  }

  //sharpe droite
  distance3 = get_IR3 ();
  if (distance3 <= sueil_infra_gauche)
  {
    return (4);
  }
  return (0);
}
double get_IR1 () {
  double value;
  value = analogRead (pin1); //sharp arriere
  if (value < 16)  value = 16;
  return 2076.0 / (value - 11.0);
}
double get_IR2 () {
  double value;
  value = analogRead (pin2); //sharpe gauche
  if (value < 16)  value = 16;
  return 2076.0 / (value - 11.0);
}
double get_IR3 () {
  double value;
  value = analogRead (pin3); //sharpe droite
  if (value < 16)  value = 16;
  return 2076.0 / (value - 11.0);
}



void debug_Aquisition(void) {
  // récuparétion état capteur sharpe
  byte etat = Priocapte(Checkcapte());

  //Récupération valeurs brut retourner par le capteur sharpe
  Serial.print(get_IR1());
  Serial.print(" ==> SHARPE ARRIERRE  ");
  Serial.print(get_IR2());
  Serial.print(" ==> SHARPE Gauche    ");
  Serial.print(get_IR3());
  Serial.print(" ==> SHARPE DROITE  ");
  // récupération de la distance ultrasond
  aquisition();
  Serial.print(lecture_echo);
  Serial.print(" ==>  Ultrasond      ");
  // récupération de l'état de ligne
  int AR_debug_value =analogRead(input_ligne_ar);
  
  int AV_G_debug_value = analogRead(input_ligne_ar_G); 
  int AV_D_debug_value = analogRead(input_ligne_ar_D);

  Serial.print(AR_debug_value); 
  Serial.print("===>ligne_AR    "); 
  Serial.print(AV_G_debug_value); 
  Serial.print("===>ligne_AV_G  "); 
  Serial.print(AV_D_debug_value); 
  Serial.println("==>ligne_AV_D"); 



  Serial.println("#############################");
  
  
  
  // Serial.println(etat, BIN);

  //  digitalWrite(led_g,HIGH);

}

void debug_mouvement(void){
  /*Mouvement que l'on veux que le robot effectue*/
//  ###########//#####
//  ###########//#####
//  ##########//######
//  ########//########
//  ######//##########
//  ########//########
//  ##########//######
//  ###########//#####
//  ###########//#####
//  ###########//#####
mouvement(TOUT_DROIT);
delay(1000); 
mouvement(GAUCHE); 
delay(1000); 
mouvement(DROITE); 
delay(2000); 
mouvement(TOUT_DROIT); 
delay(1000); 
mouvement(MARCHE_ARRIERE);


}
void loop() {
  //Ligne Loop
 //
 //debug_Aquisition();
  
 //Serial.println( sharp()); 
 
 //debug_mouvement();
  mouvement(STOP);
  arret = 0 ;
  while (pulseIn(remote,LOW)<5000){ //attente de recevoir une trame
    //if(digitalRead(button) ==  LOW)break; // attente de l'appui sur le bouton
  }
  while (digitalRead(button) == LOW);  // attente du relachement du bouton
  digitalWrite(led_b, HIGH);
 // delay(4985);  //5 second d'attente
 
  mouvement(MARCHE_ARRIERE);
  while (arret == 0)
  {
    action ();
    if (digitalRead(button) == LOW) {
      arret = 1;
    }
  }
  while (digitalRead(button) == LOW); // attente du relachement du bouton
  
}
