nopisland/Sumositoire/(commit log)

2026-01-16 ajout du QR_code
    [Sumositoire_reborn.kicad_pcb]
2026-01-22 création de fichier gerber
    [BOM-Sumositoire_reborn.csv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]
2026-02-10 indicateur batterie
    [indicateur_batterie_v1.kicad_pcb, indicateur_batterie_v1.kicad_sch]
2026-03-27 changement déclanchement télécomande
    [indicateur_batterie_v1.kicad_pcb, indicateur_batterie_v1.kicad_sch]
2026-07-16 mise à jour des dépenses avec les librairies de symboles
    [Sumositoire_reborn.kicad_sch]
2026-07-17 suppression de commentaires sur les pistes d'amélioration du robot qui ont été corrigées
    [Sumositoire_reborn.kicad_sch]
2026-10-26 ajout d'un code de test de et modification des seuils de détection
